Vibrant-Media-Lab/Weather-Station-v3/docs/Aerocone_Test_Wiring_Diagram.png

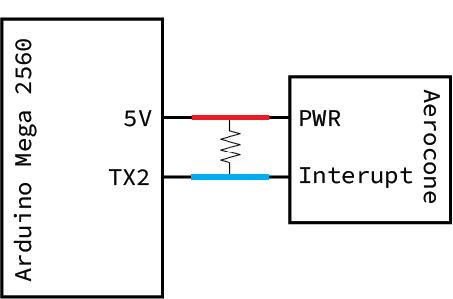
docs/Aerocone_Test_Wiring_Diagram.png
