Vibrant-Media-Lab/Weather-Station-v3/docs/Anemometer_Test_Wiring_Diagram.png

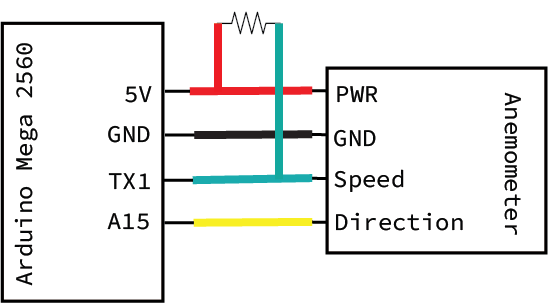
docs/Anemometer_Test_Wiring_Diagram.png
