Vibrant-Media-Lab/Weather-Station-v3/docs/BMP280_Test_Wiring_Diagram.png

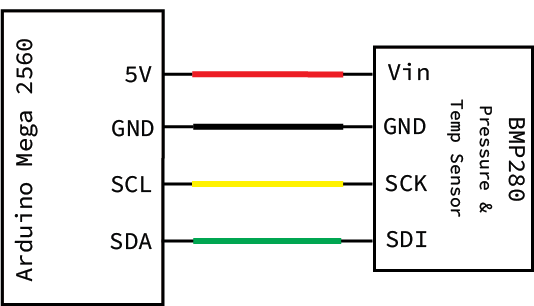
docs/BMP280_Test_Wiring_Diagram.png
