Vibrant-Media-Lab/Weather-Station-v3/docs/LCD_Test_Wiring_Diagram.png

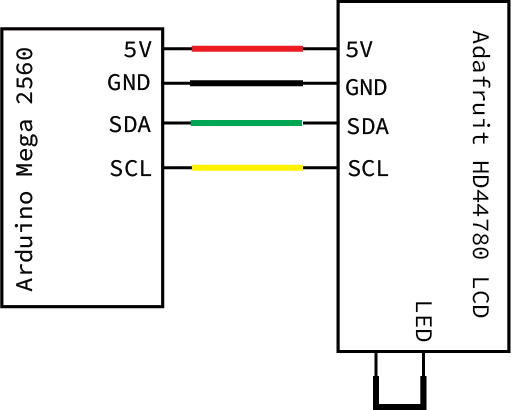
docs/LCD_Test_Wiring_Diagram.png
