Vibrant-Media-Lab/Weather-Station-v3/docs/Weather_Station_Wiring_Diagram.png

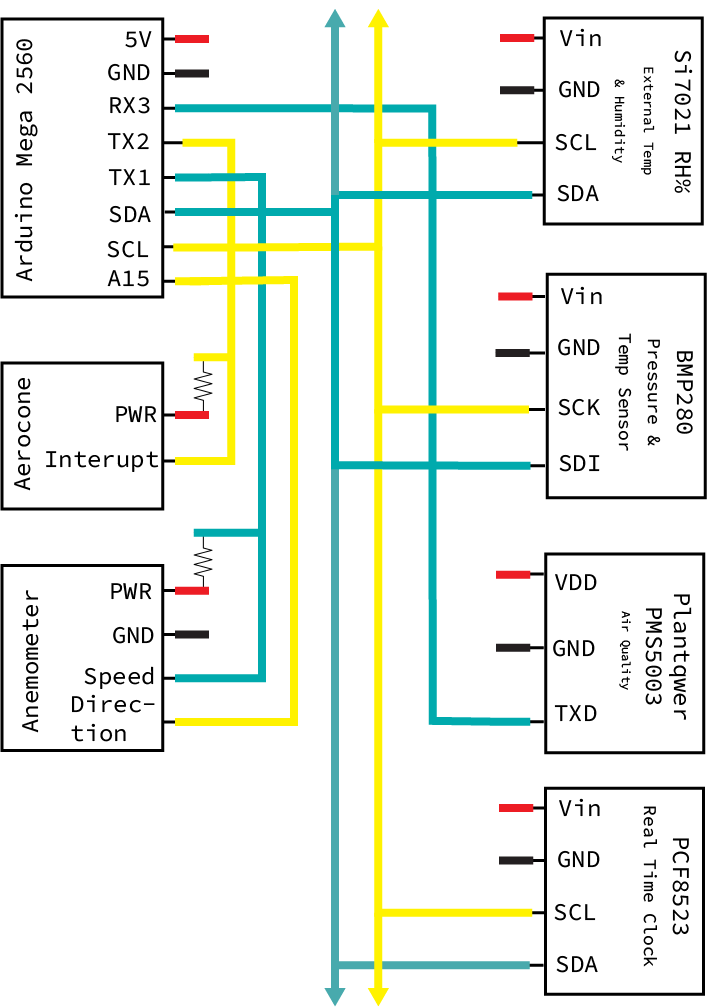
docs/Weather_Station_Wiring_Diagram.png
