Vibrant-Media-Lab/Weather-Station-v3/code/componentTests/si7021_test/si7021_test.ino

#include "Adafruit_Si7021.h"

bool enableHeater = false;
uint8_t loopCnt = 0;

Adafruit_Si7021 sensor = Adafruit_Si7021();

void setup() {
  Serial.begin(115200);

  // wait for serial port to open
  while (!Serial) {
    delay(10);
  }

  Serial.println("Si7021 test!\n");
  
  if (!sensor.begin()) {
    Serial.println("Did not find Si7021 sensor!");
    while (true)
      ;
  }
}

void loop() {
  Serial.print("Humidity: ");
  Serial.print(sensor.readHumidity(), 2);
  Serial.print("\tTemperature: ");
  Serial.println(sensor.readTemperature(), 2);
  delay(1000);
}
