Vibrant-Media-Lab/Weather-Station-v3/(commit log)

2023-11-17 debugged Arduino sketch, added web server capabilities and the corresponding files
    [log.csv]
2023-12-01 Updated the README file with basic information about sensors and collected data
2023-12-13 updated web app directory organization
    [log.csv]
2023-12-13 Continued to update website to include daily data
    [log.csv]
2023-12-14 Fixed the variable used to log previous day's values to the SD card
    [weatherStationClaytonsVersion.ino]
2023-12-14 Added component tests for RTC, anemometer, and temp/pressure sensor
2023-12-14 changed air pressure to barometric pressure
2023-12-14 added average weather, weather interrupt, comments
2023-12-14 Fixed the Air Quality Sensor. Now we get data from it!
    [weatherStationClaytonsVersion.ino]
2023-12-16 Edited block diagram to include pull up resistors
2023-12-16 Added wiring diagrams for all the tests
2023-12-16 Rename Weather Station Block Diagram.png to Weather Station Wiring Diagram.png
2023-12-16 Rename Weather Station Wiring Diagram.png to Weather_Station_Wiring_Diagram.png
